ENACRobotique/interface_robot/Carte_LCD_FarmingMars/Carte_LCD_FarmingMars.kicad_pcb

## KiCad design Carte_LCD_FarmingMars/Carte_LCD_FarmingMars.kicad_pcb (2024-04-08)

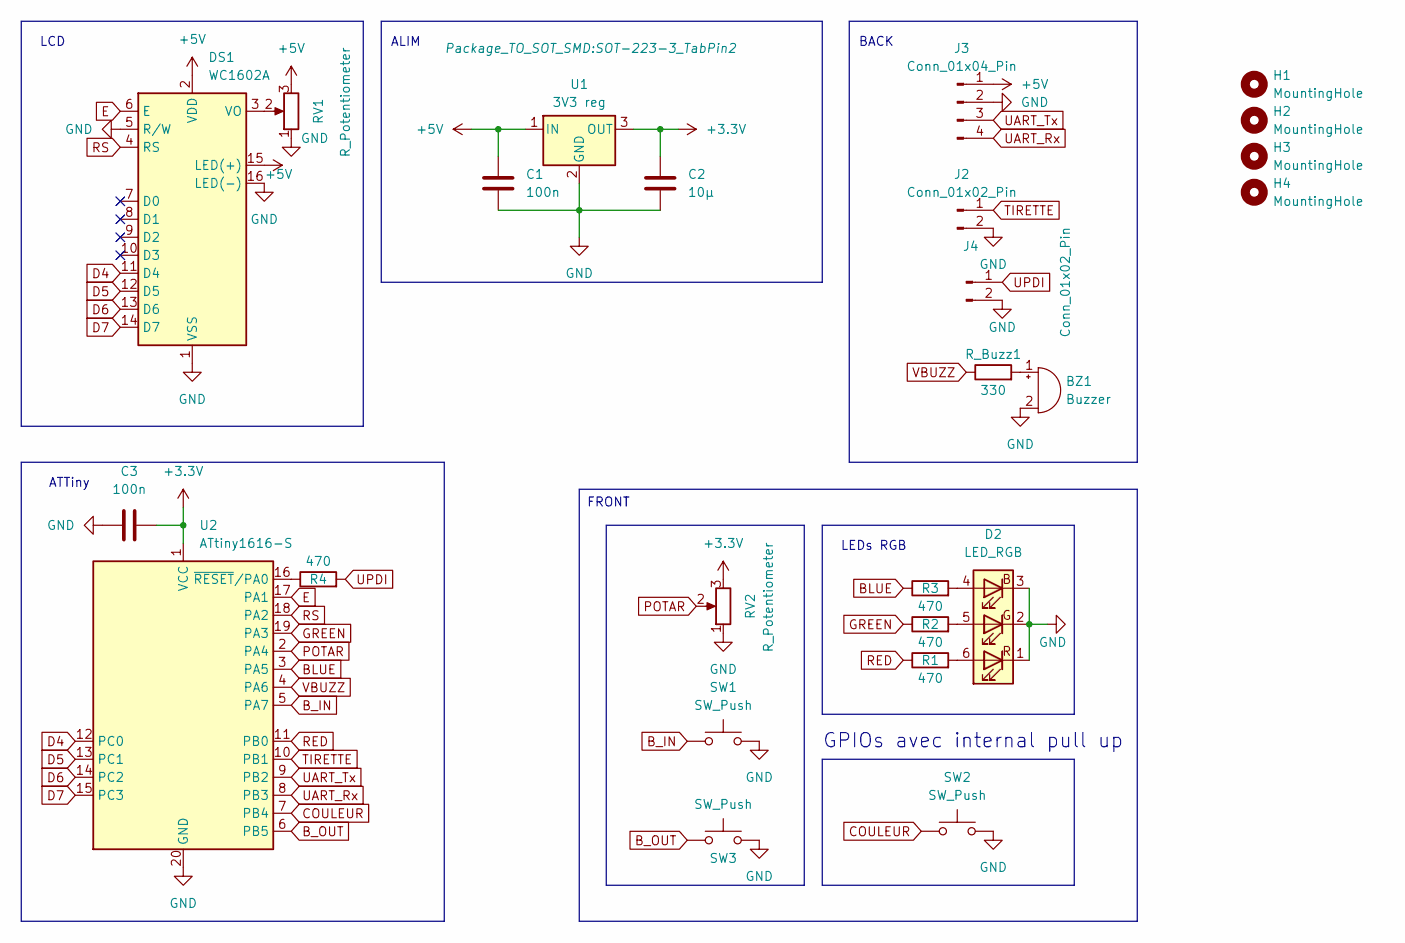
[picture p1: schematic Carte_LCD_FarmingMars.kicad_sch]

Parts:
BZ1: Buzzer; MagneticBuzzer_ProSignal_ABT-410-RC
C1, C3: 100n; C_0603_1608Metric
C2: 10µ; C_0603_1608Metric
D2: LED_RGB; PLCC6_CLP6C-FKB
DS1: WC1602A
H1, H2, H3, H4: MountingHole; MountingHole_3.2mm_M3
J2, J4: Conn_01x02_Pin; PinHeader_1x02_P2.54mm_Horizontal
J3: Conn_01x04_Pin; PinHeader_1x04_P2.54mm_Horizontal
R1, R2, R3, R4: 470; R_0603_1608Metric
RV1: R_Potentiometer; TS53YL
RV2: R_Potentiometer; Potentiometer_Bourns_PTV09A-1_Single_Vertical
R_Buzz1: 330; R_0603_1608Metric
SW1, SW2, SW3: SW_Push; SWITCH_DTSM31NV
U1: 3V3 reg; SOT-223-3_TabPin2
U2: ATtiny1616-S; SOIC-20W_7.5x12.8mm_P1.27mm

Connections:
+3.3V: C2.1, C3.2, RV2.3, U1.3 (OUT), U2.1 (VCC)
+5V: C1.1, DS1.2 (VDD), DS1.15 (LED(+)), J3.1, RV1.3, U1.1 (IN)
BLUE: R3.1, U2.3 (PA5)
B_IN: SW1.1, U2.5 (PA7)
B_OUT: SW3.1, U2.6 (PB5)
COULEUR: SW2.1, U2.7 (PB4)
D4: DS1.11 (D4), U2.12 (PC0)
D5: DS1.12 (D5), U2.13 (PC1)
D6: DS1.13 (D6), U2.14 (PC2)
D7: DS1.14 (D7), U2.15 (PC3)
E: DS1.6 (E), U2.17 (PA1)
GND: BZ1.2 (+), C1.2, C2.2, C3.1, D2.1 (RK), D2.2 (GK), D2.3 (BK), DS1.1 (VSS), DS1.5 (R/W), DS1.16 (LED(-)), J2.2, J3.2, J4.2, RV1.1, RV2.1, SW1.2, SW2.2, SW3.2, U1.2 (GND), U2.20 (GND)
GREEN: R2.1, U2.19 (PA3)
unnamed: BZ1.1 (-), R_Buzz1.2
unnamed: D2.4 (BA), R3.2
unnamed: D2.5 (GA), R2.2
unnamed: D2.6 (RA), R1.2
unnamed: DS1.3 (VO), RV1.2
unnamed: R4.1, U2.16 (~RESET/PA0)
POTAR: RV2.2, U2.2 (PA4)
RED: R1.1, U2.11 (PB0)
RS: DS1.4 (RS), U2.18 (PA2)
TIRETTE: J2.1, U2.10 (PB1)
UART_Rx: J3.4, U2.8 (PB3)
UART_Tx: J3.3, U2.9 (PB2)
UPDI: J4.1, R4.2
VBUZZ: R_Buzz1.1, U2.4 (PA6)

Notes on the sheet:
FRONT
LEDs RGB
GPIOs avec internal pull up
LCD
ATTiny
BACK
ALIM

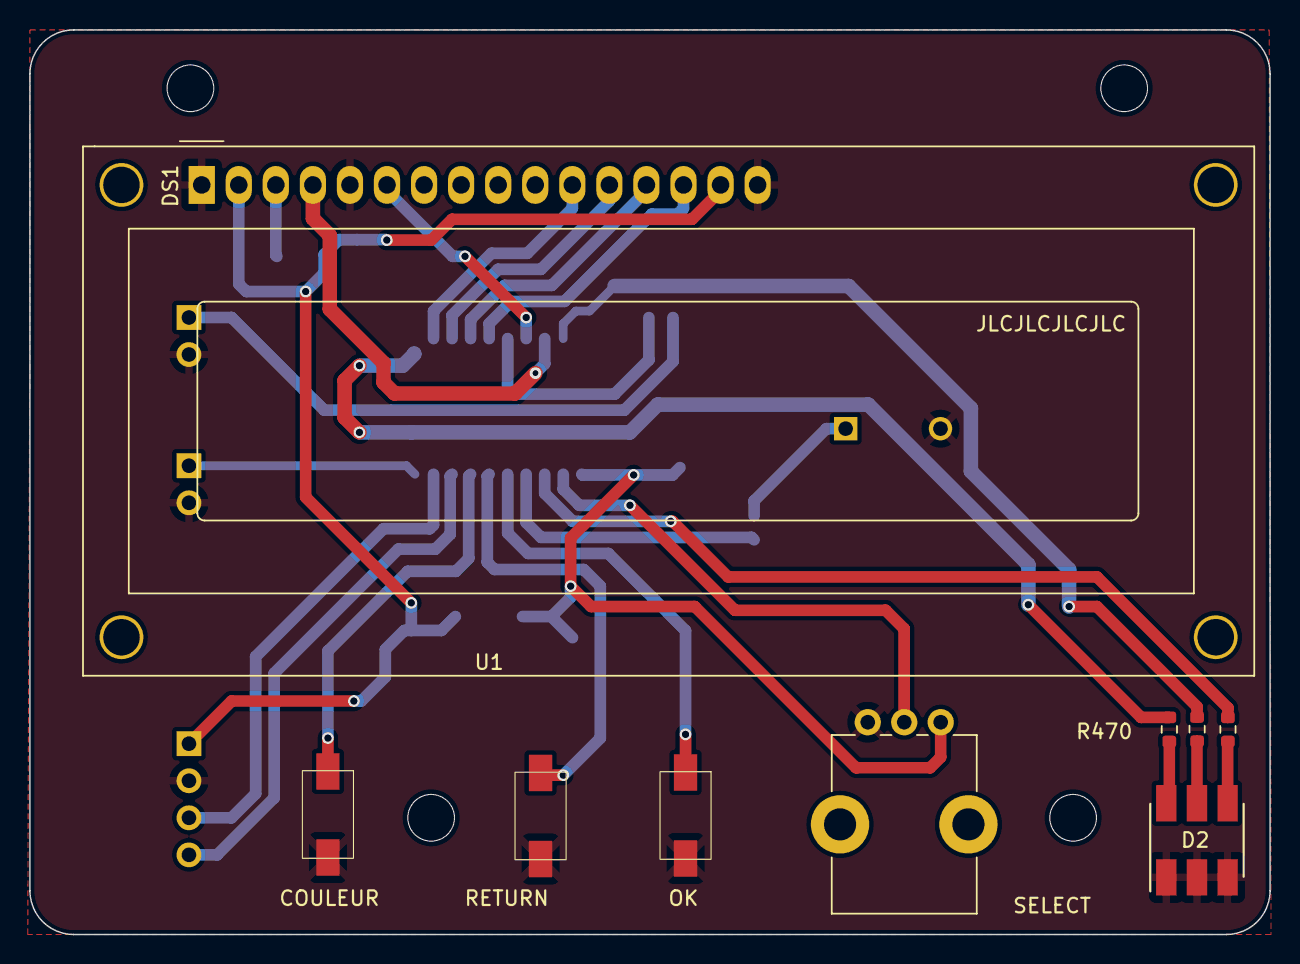
[picture p2: board Carte_LCD_FarmingMars.kicad_pcb from above]

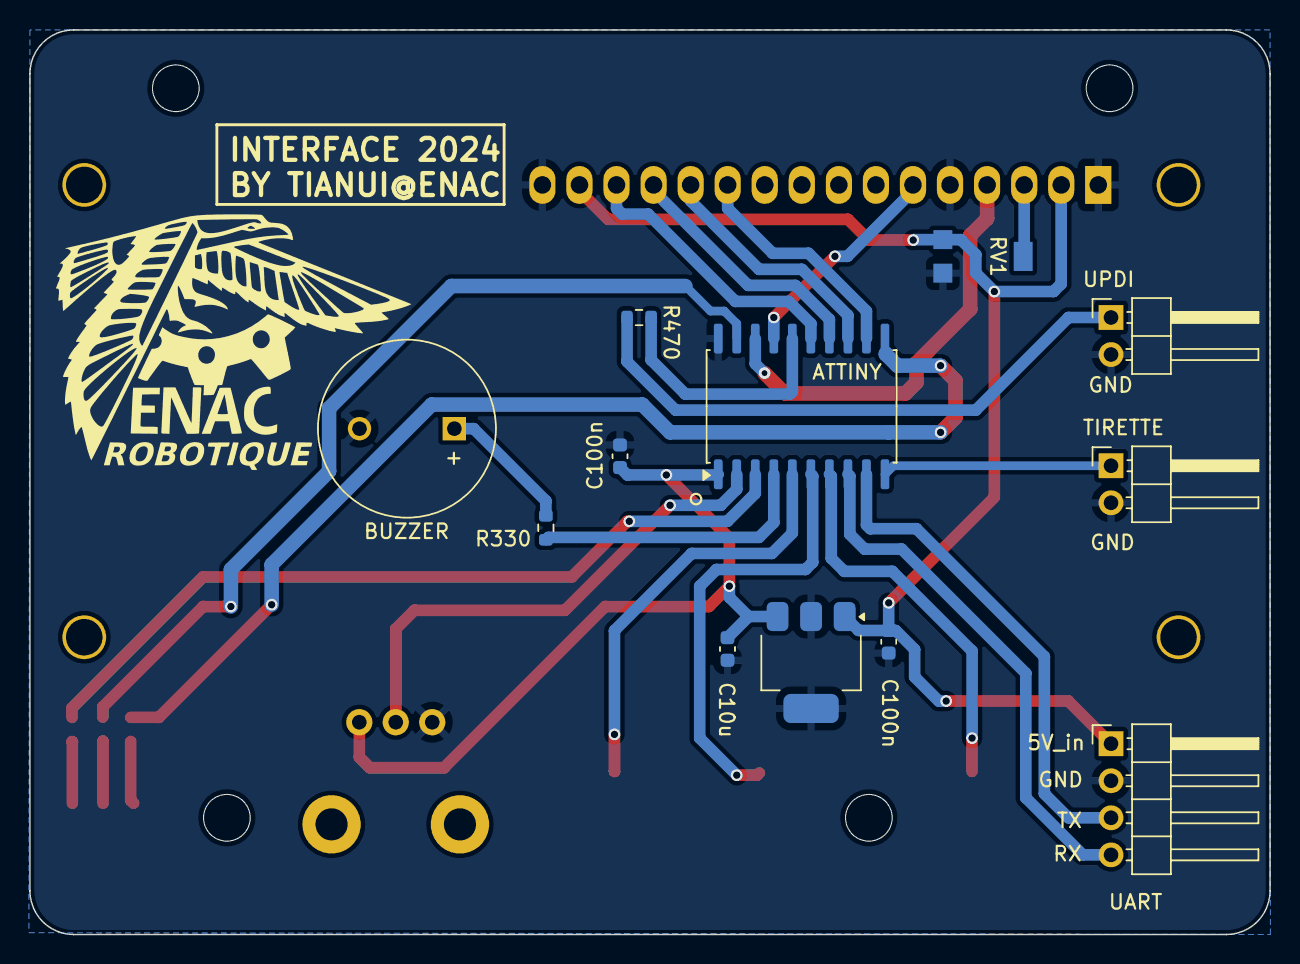
[picture p3: board Carte_LCD_FarmingMars.kicad_pcb from below]

Board: 2 copper layers, 85.0 x 62.0 mm, 25 parts (12 on the bottom side), 27 nets.
