ENACRobotique/interface_robot/(threads)

Thread 1 (2024-04-19):

Faire le code de la carte LCD

Fabien-B, 2024-04-19:
2 manières possible de faire pour la communication LCD -> raspi:
- orientée état: le LCD envoie régulièrement l'état des boutons, ...
    - Pro : très simple, robuste aux pertes de messages
    - Con: forte latence, spam en permanence
- orientée évènement: le LCD n'envoie un message que lors d'un changement (appui sur un bouton, ...)
    - Pro: faible latence, faible nombres de messages
    - Con: on peut rater un message. On peut cependant renvoyer plusieurs fois les messages importants (tirette)
