ENACRobotique/interface_robot/(commit log)

2024-01-25 Début LCD
    [Carte_LCD_FarmingMars.kicad_pcb, Carte_LCD_FarmingMars.kicad_sch]
2024-02-01 Followed discord changes
    [Carte_LCD_FarmingMars.kicad_sch]
2024-02-01 Placement préliminaire PCB
    [Carte_LCD_FarmingMars.kicad_pcb, Carte_LCD_FarmingMars.kicad_sch]
2024-02-29 placement composants
    [Carte_LCD_FarmingMars.kicad_pcb, Carte_LCD_FarmingMars.kicad_sch]
2024-03-19 Routage, inversion pin Couleur et Vbuzz
    [Carte_LCD_FarmingMars.kicad_pcb, Carte_LCD_FarmingMars.kicad_sch]
2024-03-22 Corrections, Verification , prêt à commander !
    [Carte_LCD_FarmingMars.kicad_pcb]
2024-04-08 ajoute texte et marque pin1
    [Carte_LCD_FarmingMars.kicad_pcb]
2024-04-08 release V1
    [Carte_LCD_FarmingMars.kicad_pcb, Carte_LCD_FarmingMars.kicad_sch]
2024-04-17 code de test
2024-04-20 Ajoute Open et Closed aux valeurs possible des boutons
2024-04-20 gère les erreurs de transmission
2024-04-20 Driver python
2024-04-22 fix firmaware and driver
    [lcd.py, main.cpp, params.h]
